mattheas/Experimenting-With-PS3-PWM-Fan-Control/images/Fan_Mounted_2.png

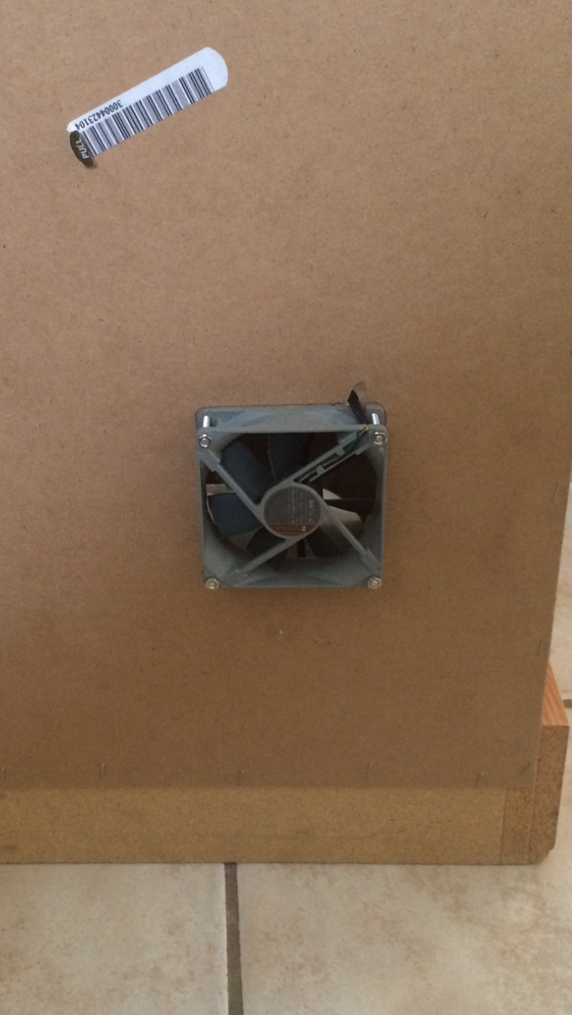
images/Fan_Mounted_2.png
